GreatMesa/Servo-ESC/Hardware/SERVO-ESC/bob.stl

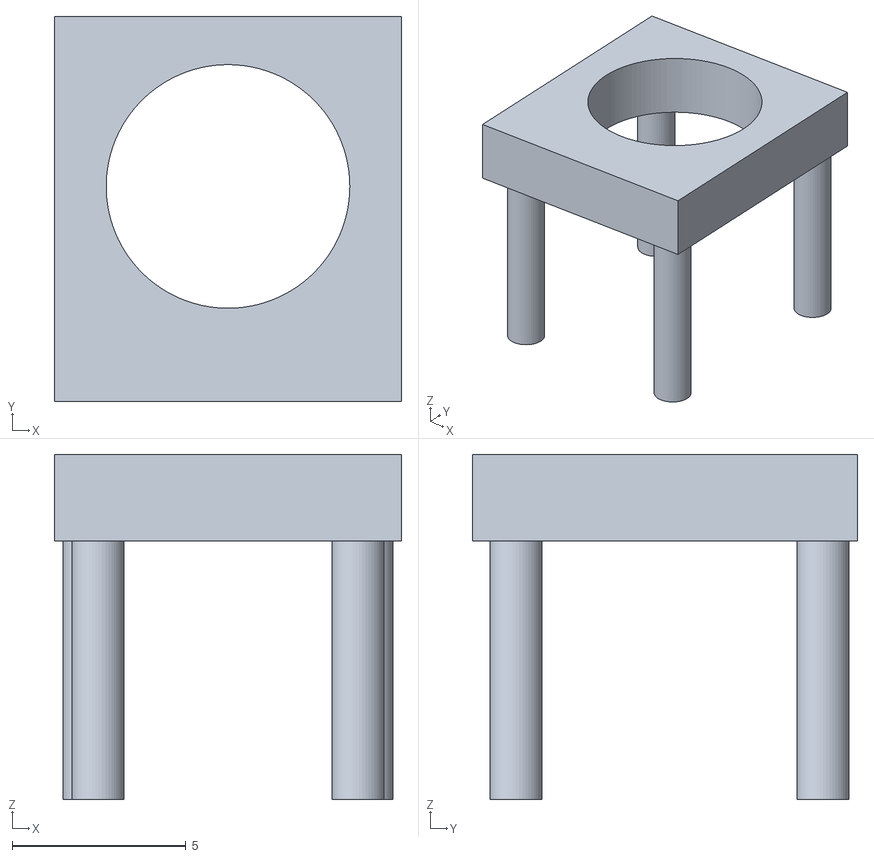
[picture p1: CAD file, 2026-04-23]
Hardware/SERVO-ESC/bob.stl
10.0 x 11.1 x 9.95
