GreatMesa/Servo-ESC/Hardware/SERVO-ESC/pan1.3mf

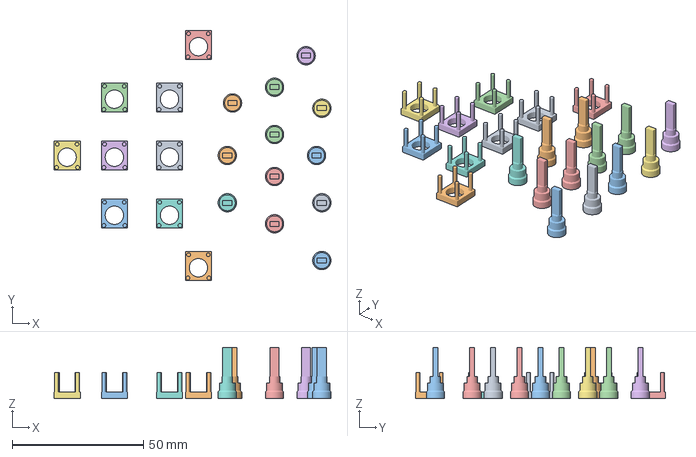
[picture p2: CAD file, 2026-04-23]
Hardware/SERVO-ESC/pan1.3mf
105.5 x 95.3 x 19.5 mm
bob.stl x 9
pan5.stl x 12
