GreatMesa/Servo-ESC/Hardware/SERVO-ESC/pan5.stl

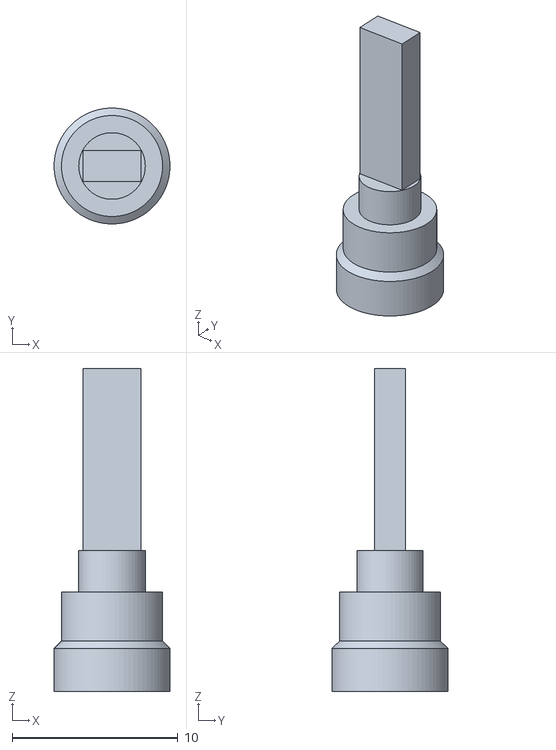
[picture p3: CAD file, 2026-04-23]
Hardware/SERVO-ESC/pan5.stl
7.00 x 7.00 x 19.5
