GreatMesa/Servo-ESC/Hardware/SERVO-ESC/pan.stl

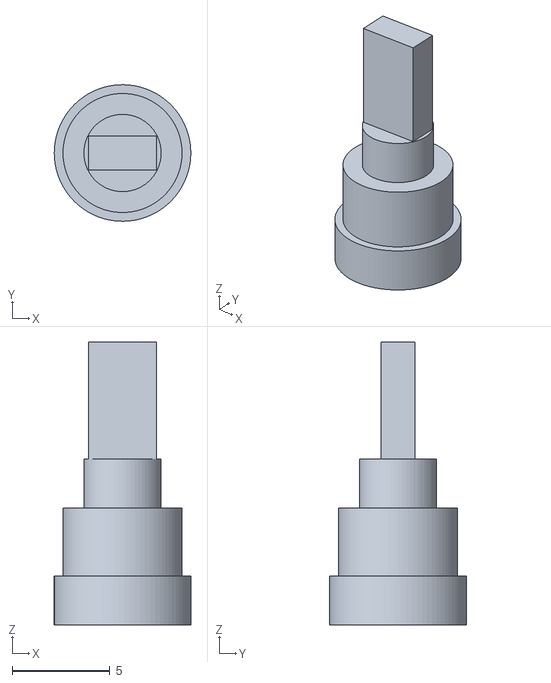
[picture p4: CAD file, 2026-03-27]
Hardware/SERVO-ESC/pan.stl
7.00 x 7.00 x 14.5
