GreatMesa/Servo-ESC/Hardware/SERVO-ESC/Untitled.stl

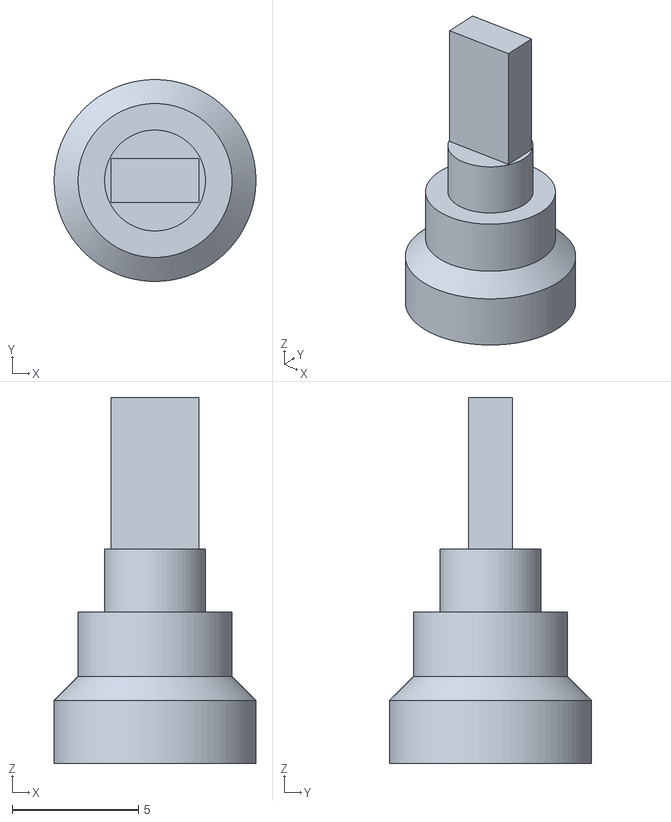
[picture p5: CAD file, 2026-03-27]
Hardware/SERVO-ESC/Untitled.stl
8.00 x 8.00 x 14.5
