GreatMesa/Servo-ESC/Hardware/SERVO-ESC/halp.stl

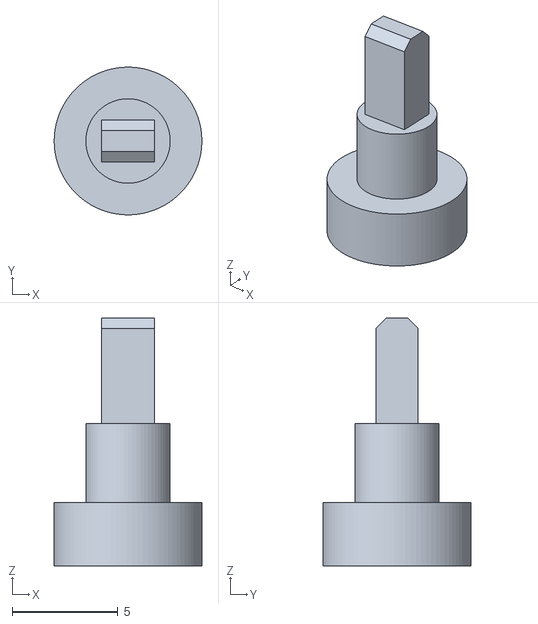
[picture p6: CAD file, 2026-03-24]
Hardware/SERVO-ESC/halp.stl
7.00 x 7.00 x 11.8
