GreatMesa/Servo-ESC/Hardware/SERVO-ESC/SERVO-ESC.step

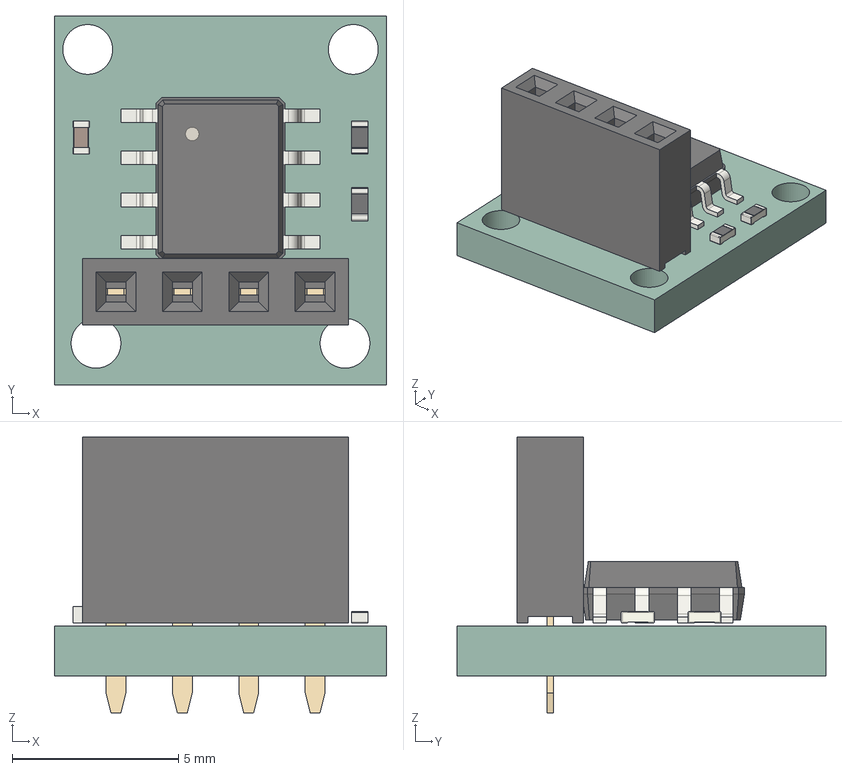
[picture p7: CAD file, 2026-03-24]
Hardware/SERVO-ESC/SERVO-ESC.step
10.0 x 11.1 x 8.30 mm
C_0402_1005Metric
R_0402_1005Metric x 2
PinSocket_1x04_P2.00mm_Vertical
SO-8_3.9x4.9mm_P1.27mm
SERVO-ESC_PCB
