GreatMesa/Servo-ESC/(list of files, cad)

Other CAD files:
Hardware/SERVO-ESC/pan2.stl
Hardware/SERVO-ESC/pan4.stl
Hardware/SERVO-ESC/pan3.stl
Hardware/SERVO-ESC/pan1.stl
