GreatMesa/Servo-ESC/Hardware/SERVO-ESC/SERVO-ESC.kicad_pcb

## KiCad design Hardware/SERVO-ESC/SERVO-ESC.kicad_pcb (2026-03-24)

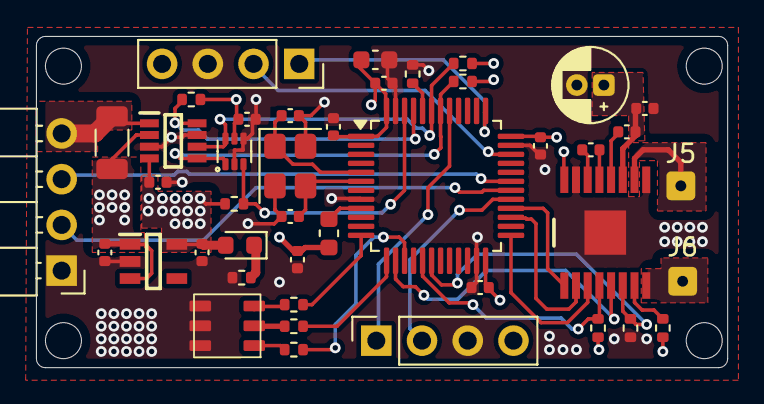
[picture p8: board SERVO-ESC.kicad_pcb from above]

Board: 4 copper layers, 38.4 x 18.4 mm, 43 parts (0 on the bottom side), 37 nets.

Parts:
C1, C2, C3, C4, C9, C10, C15: 100nF; C_0402_1005Metric
C5: 4.7uF; C_0603_1608Metric
C6, C8, C12: 1uF; C_0402_1005Metric
C7: 22nF; C_0402_1005Metric
C11: 22uF; CP_Radial_D4.0mm_P1.50mm
C13, C14: 30pF; C_0402_1005Metric
C16: 10nF; C_0402_1005Metric
D1: LED; LED_0603_1608Metric
FB1: FerriteBead; L_0603_1608Metric
IC1: AP2112K; SOT95P285X140-5N
IC2: DRV8876PWPR; SOP65P640X120-17N
IC4: TMP102xxDRL; SOT-563
IC5: INA236AIDDFR; SOP65P280X110-8N
J1: Conn_01x04_Pin; PinHeader_1x04_P2.54mm_Horizontal
J2, J4: Conn_01x04_Pin; PinSocket_1x04_P2.54mm_Vertical
J5: +; SolderWire-0.1sqmm_1x01_D0.4mm_OD1mm
J6: -; SolderWire-0.1sqmm_1x01_D0.4mm_OD1mm
LED1: Untitled_1
R1, R10: 10k; R_0402_1005Metric
R2, R3, R4: 220; R_0402_1005Metric
R5, R6, R12, R13: 4.7k; R_0402_1005Metric
R7: 1k; R_0402_1005Metric
R8: 62k; R_0402_1005Metric
R9: 8.25k; R_0402_1005Metric
R11: 0.01; R_1206_3216Metric
U1: STM32F301C8Tx; LQFP-48_7x7mm_P0.5mm
Y1: 25MHZ; Crystal_SMD_3225-4Pin_3.2x2.5mm

Connections:
+3.3V: C1.1, C2.1, C3.1, C4.1, C5.1, C8.1, C12.1, C15.1, C16.1, D1.2 (A), FB1.2, IC1.5 (VOUT), IC2.16 (PMODE), IC4.5 (V+), IC5.4 (VS), J2.4, J4.4, R5.1, R6.1, R8.2, R10.1, R12.1, R13.1, U1.1 (VBAT), U1.24 (VDD), U1.36 (VDD), U1.48 (VDD)
+3.3VA: FB1.1, U1.9 (VDDA)
+7V: C6.1, C9.1, C10.1, C11.1, IC1.1 (VIN), IC1.3 (EN), IC2.11 (VM), IC5.2 (IN-), R11.2
+SV: IC5.1 (IN+), J1.4, R11.1
CPH: C7.2, IC2.13 (CPH)
CPL: C7.1, IC2.14 (CPL)
GND: C1.2, C2.2, C3.2, C4.2, C5.2, C6.2, C8.2, C9.2, C11.2, C12.2, C13.2, C14.2, C15.2, C16.2, IC1.2 (GND), IC2.9 (PGND), IC2.15 (GND), IC2.17 (EP), IC4.2 (GND), IC4.4 (ADD0), IC5.3 (GND), IC5.7 (A0), J1.1, J2.3, J4.3, LED1.1, LED1.2, LED1.3, R1.1, R7.2, R9.2, U1.8 (VSSA), U1.23 (VSS), U1.35 (VSS), U1.47 (VSS), Y1.2, Y1.4
HBRIDGE+: IC2.8 (OUT1), J6.1
HBRIDGE-: IC2.10 (OUT2), J5.1
HBRIDGE-FAULT: IC2.4 (NFAULT), R8.1, U1.17 (PA7)
HBRIDGE-IMODE: IC2.7 (IMODE), R10.2
HBRIDGE-IN1: IC2.1 (EN/IN1), U1.28 (PB15)
HBRIDGE-IN2: IC2.2 (PH/IN2), U1.27 (PB14)
HBRIDGE-IPROPI: IC2.6 (IPROPI), R9.1, U1.18 (PB0)
HBRIDGE-SLEEP: IC2.3 (NSLEEP), U1.25 (PB12)
HBRIDGE-VREF: IC2.5 (VREF), U1.14 (PA4)
HSE-IN: C13.1, U1.5 (PF0), Y1.1
HSE-OUT: C14.1, U1.6 (PF1), Y1.3
I2C-SCL-1: IC4.1 (SCL), IC5.5 (SCL), R5.2, U1.42 (PB6)
I2C-SCL-3: J4.2, U1.29 (PA8)
I2C-SDA-1: IC4.6 (SDA), IC5.6 (SDA), R6.2, U1.43 (PB7)
I2C-SDA-3: J4.1, U1.41 (PB5)
INA236-INT: IC5.8 (~ALERT), R12.2, U1.45 (PB8)
unnamed: D1.1 (K), R7.1
unnamed: LED1.4, R2.1
unnamed: LED1.5, R3.1
unnamed: LED1.6, R4.1
unnamed: R1.2, U1.44 (BOOT0)
RGB-LED-BLUE: R4.2, U1.12 (PA2)
RGB-LED-GREEN: R3.2, U1.13 (PA3)
RGB-LED-RED: R2.2, U1.15 (PA5)
SWCLK: J2.1, U1.37 (PA14)
SWDIO: J2.2, U1.34 (PA13)
TMP102-INT: IC4.3 (ALERT), R13.2, U1.46 (PB9)
UART-RX: J1.3, U1.31 (PA10)
UART-TX: J1.2, U1.30 (PA9)
VCP: C10.2, IC2.12 (VCP)
