GreatMesa/Servo-ESC/Software/Core/Src/main.c

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
/* Includes ------------------------------------------------------------------*/
#include "main.h"
#include "cmsis_os.h"
#include "stdbool.h"
#include "DRV8876.h"
#include "RGBLED.h"
#include "INA236.h"
#include "MT6701.h"
#include "TMP102.h"
#include "pid.h"
#include "cmsis_os2.h"
#include "stm32f3xx_hal_gpio.h"
#include <stdint.h>
#include <sys/types.h>
#define ina236Flag (1U << 0)
#define tmp102Flag (1U << 1)
ADC_HandleTypeDef hadc1;

DAC_HandleTypeDef hdac;

I2C_HandleTypeDef hi2c1;
I2C_HandleTypeDef hi2c2;
I2C_HandleTypeDef hi2c3;

TIM_HandleTypeDef htim2;
TIM_HandleTypeDef htim15;

void diagnosticsTask(void *argument);
void encoderTask(void *argument);
void driverTask(void *argument);
void pidTask(void *argument);
void i2cslaveTask(void *argument);

/*Diagnostics Task Handle*/
osThreadId_t diagnosticsTaskHandle;
const osThreadAttr_t diagnosticsTask_attr = {
  .name = "Diagnositic Task",
  .stack_size = 128 * 4,
  .priority = (osPriority_t) osPriorityLow,
};
/*MT6701 Encoder Task Handle*/
osThreadId_t encoderTaskHandle;
const osThreadAttr_t encoderTask_attr = {
  .name = "Encoder Task",
  .stack_size = 128 * 4,
  .priority = (osPriority_t) osPriorityNormal,
};
/*DRV8876 Task*/
osThreadId_t driverTaskHandle;
const osThreadAttr_t driverTask_attr = {
  .name = "Driver Task",
  .stack_size = 128 * 4,
  .priority = (osPriority_t) osPriorityNormal,
};

osThreadId_t pidTaskHandle;
const osThreadAttr_t pidTask_attr = {
  .name = "PID Task",
  .stack_size = 128 * 4,
  .priority = (osPriority_t) osPriorityNormal,
};

osThreadId_t i2cslaveTaskHandle;
const osThreadAttr_t i2cslaveTask_attr = {
  .name = "I2C Task",
  .stack_size = 128 * 4,
  .priority = (osPriority_t) osPriorityNormal,
};

/* USER CODE BEGIN PV */
DRV8876 drv;
MT6701 encoder;
RGBLED led;
INA236 ina;
TMP102 tmp;
PID pid;
/* USER CODE END PV */

void SystemClock_Config(void);
static void MX_GPIO_Init(void);
static void MX_ADC1_Init(void);
static void MX_DAC_Init(void);
static void MX_I2C1_Init(void);
static void MX_TIM2_Init(void);
static void MX_I2C3_Init(void);
static void MX_TIM15_Init(void);
static void MX_I2C2_Init(void);

/**
  * @brief  The application entry point.
  * @retval int
  */
int main(void)
{
  /* MCU Configuration--------------------------------------------------------*/

  /* Reset of all peripherals, Initializes the Flash interface and the Systick. */
  HAL_Init();
  /* Configure the system clock */
  SystemClock_Config();

  /* Initialize all configured peripherals */
  MX_GPIO_Init();

  MX_ADC1_Init();
  MX_DAC_Init();
  MX_I2C1_Init();
  MX_TIM2_Init();
  MX_I2C3_Init();
  MX_TIM15_Init();
  MX_I2C2_Init();
  /* USER CODE BEGIN 2 */
  /* Initializing Drivers */
  INA236_Initialize(&ina, &hi2c1);
  TMP102_Initialize(&tmp, &hi2c1, TMP102_ALERT_GPIO_Port);
  MT6701_Initialize(&encoder, &hi2c3);
  DRV8876_Initialize(&drv, &htim15, &hadc1, &hdac, HBRIDGE_SLEEP_GPIO_Port,HBRIDGE_SLEEP_Pin, HBRIDGE_FALUT_GPIO_Port, HBRIDGE_FALUT_Pin);
  RGBLED_Initialize(&led, &htim2);
  PID_Initialize(&pid, 0.1 , 0.2, 0.3, 0.4, 0.5);
  setVelocity(&drv, 64000);
  /* USER CODE END 2 */
  
  /* Init scheduler */
  osKernelInitialize();

  /* USER CODE BEGIN RTOS_MUTEX */
  /* add mutexes, ... */
  /* USER CODE END RTOS_MUTEX */

  /* USER CODE BEGIN RTOS_SEMAPHORES */
  /* add semaphores, ... */
  /* USER CODE END RTOS_SEMAPHORES */

  /* USER CODE BEGIN RTOS_TIMERS */
  /* start timers, add new ones, ... */
  /* USER CODE END RTOS_TIMERS */

  /* USER CODE BEGIN RTOS_QUEUES */
  /* add queues, ... */
  /* USER CODE END RTOS_QUEUES */

  /* Create the thread(s) */
  /* creation of defaultTask */

  /* USER CODE BEGIN RTOS_THREADS */
  diagnosticsTaskHandle = osThreadNew(diagnosticsTask,NULL,&diagnosticsTask_attr);
  encoderTaskHandle = osThreadNew(encoderTask,NULL,&encoderTask_attr);
  driverTaskHandle = osThreadNew(driverTask,NULL,&driverTask_attr);
  //pidTaskHandle = osThreadNew(pidTask,NULL,&pidTask_attr);
  //i2cslaveTaskHandle = osThreadNew(i2cslaveTask,NULL,&i2cslaveTask_attr);
  /* add threads, ... */
  /* USER CODE END RTOS_THREADS */

  /* USER CODE BEGIN RTOS_EVENTS */
  /* add events, ... */
  /* USER CODE END RTOS_EVENTS */
  
  /* Start scheduler */
  osKernelStart();

  /* We should never get here as control is now taken by the scheduler */

  /* Infinite loop */
  /* USER CODE BEGIN WHILE */
  while (1)
  {
    /* USER CODE END WHILE */

    /* USER CODE BEGIN 3 */
  }
  /* USER CODE END 3 */
}


void diagnosticsTask(void *argument)
{
  for(;;)
  {
    uint32_t flags = osThreadFlagsWait(tmp102Flag | ina236Flag, osFlagsWaitAny, osWaitForever);
      if(flags & tmp102Flag)
      {
        TMP102_Read(&tmp);
      }
      if(flags & ina236Flag)
      {
        INA236_Read(&ina);
      }
  }
}

void encoderTask(void *argument)
{
  for(;;)
  {
    MT6701_Read(&encoder);
    getRPM(&encoder, 10,0.2);
    osDelay(5);
  }
}
void pidTask(void *argument)
{
  for(;;)
  {
    PID_Step(&pid, 7, 8, 5, 5, 4, 4);
    setVelocity(&drv, pid.power);
  }
}

void driverTask(void *argument)
{
    for(;;)
  {
    if(drv.state == SLEEP)
    {
        HAL_GPIO_WritePin(HBRIDGE_SLEEP_GPIO_Port, HBRIDGE_SLEEP_Pin, 0);
    }
    else if(drv.state == COAST)
    {
        //Slows down the motor with a gradual decent.
        HAL_GPIO_WritePin(HBRIDGE_SLEEP_GPIO_Port, HBRIDGE_SLEEP_Pin, 1);
        __HAL_TIM_SET_COMPARE(drv.tim, TIM_CHANNEL_1, 0);
        __HAL_TIM_SET_COMPARE(drv.tim, TIM_CHANNEL_2, 0);
    }
    else if(drv.state == REVERSE)
    {
        /*
        */
        HAL_GPIO_WritePin(HBRIDGE_SLEEP_GPIO_Port, HBRIDGE_SLEEP_Pin, 1);
        __HAL_TIM_SET_COMPARE(drv.tim, TIM_CHANNEL_1, 0);
        __HAL_TIM_SET_COMPARE(drv.tim, TIM_CHANNEL_2, drv.speed);
    }
    else if(drv.state == FORWARD)
    {
        HAL_GPIO_WritePin(HBRIDGE_SLEEP_GPIO_Port, HBRIDGE_SLEEP_Pin, 1);
        __HAL_TIM_SET_COMPARE(drv.tim, TIM_CHANNEL_1, drv.speed);
        __HAL_TIM_SET_COMPARE(drv.tim, TIM_CHANNEL_2, 0);
    }
    else if(drv.state == BRAKE)
    {
        HAL_GPIO_WritePin(HBRIDGE_SLEEP_GPIO_Port, HBRIDGE_SLEEP_Pin, 1);
        __HAL_TIM_SET_COMPARE(drv.tim, TIM_CHANNEL_1, 65535);
        __HAL_TIM_SET_COMPARE(drv.tim, TIM_CHANNEL_2, 0);
    }
    setColor(&led, drv.state);
  }
}
void i2cslaveTask(void *argument)
{
  
}
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
