GreatMesa/Servo-ESC/Software/SERVO-ESC.ioc

Mcu.UserName=STM32F301C8Tx
PA10.Signal=I2C2_SDA
PA13.Signal=SYS_JTMS-SWDIO
PA14.Signal=SYS_JTCK-SWCLK
PA2.GPIO_Label=RGB_LED_BLUE
PA2.Signal=S_TIM2_CH3
PA3.GPIO_Label=RGB_LED_GREEN
PA3.Signal=S_TIM2_CH4
PA4.GPIO_Label=HBRIDGE-VREF
PA4.Signal=COMP_DAC1_group
PA5.GPIO_Label=RGB_LED_RED
PA5.Signal=S_TIM2_CH1_ETR
PA7.GPIO_Label=HBRIDGE-FALUT
PA7.Signal=GPIO_Input
PA8.Signal=I2C3_SCL
PA9.Signal=I2C2_SCL
PB0.GPIO_Label=HBRIDGE-IPROPI
PB0.Signal=ADC1_IN11
PB12.GPIO_Label=HBRIDGE-SLEEP
PB12.Signal=GPIO_Output
PB14.Signal=S_TIM15_CH1
PB15.Signal=S_TIM15_CH2
PB5.Signal=I2C3_SDA
PB6.Signal=I2C1_SCL
PB7.Signal=I2C1_SDA
PB8.GPIO_Label=INA236_ALERT
PB8.Signal=GPXTI8
PB9.GPIO_Label=TMP102_ALERT
PB9.Signal=GPXTI9
PF0-OSC_IN.Signal=RCC_OSC_IN
PF1-OSC_OUT.Signal=RCC_OSC_OUT
