GreatMesa/Servo-ESC/Software/Core/Src/INA236.c

#include "INA236.h"
#include "stm32f3xx_hal_i2c.h"
#include <stdint.h>

uint16_t INA236_Config()
{
    // Converts initial configuration values into 16-bit message.
    return ((INA236_CONFIG_RST << 15) |
            (INA236_CONFIG_ADC_RANGE << 12) | 
            (INA236_CONFIG_AVG << 9) |
            (INA236_CONFIG_VBUSCT << 6) |
            (INA236_CONFIG_VSHCT << 3) |
            INA236_CONFIG_MODE);
}

uint16_t INA236_Callibration()
{
    // Converts shunt resistor value into needed shunt constant.
    float current_lsb = (INA236_MAX_CURRENT / 32768.0f);
    uint16_t SHUNT_CAL = ((0.00512f) / ((INA236_SHUNT_RESISTANCE) * (current_lsb))) / 4;
    return SHUNT_CAL;
}


HAL_StatusTypeDef INA236_Initialize(INA236 *ina236, I2C_HandleTypeDef *I2Chandle)
{
    // Configuring Starting Values
    ina236->I2Chandle = I2Chandle;
    ina236->config = INA236_Config();
    ina236->callibration = INA236_Callibration();
    ina236->raw_current = 0;
    ina236->raw_voltage = 0;
    ina236->raw_power = 0;
    ina236->current = 0.0f;
    ina236->power = 0.0f;
    ina236->voltage = 0.0f;
    ina236->current_lsb = (INA236_MAX_CURRENT / 32768.0f);
    uint8_t txBuf[2];
    
    //Configuring Configuration Register
    txBuf[0] = ((ina236->config >> 8) & 0xFF); txBuf[1] = (ina236->config & 0xFF);
    ina236->hal = HAL_I2C_Mem_Write(ina236->I2Chandle, INA236_I2C_ADDRESS,INA_CONFIG_REGISTER,I2C_MEMADD_SIZE_8BIT, txBuf, 2, 100);
    if(ina236->hal != HAL_OK){return ina236->hal;}
    
    //Configuring Callibration Register
    txBuf[0] = ((ina236->callibration >> 8) & 0xFF); txBuf[1] = (ina236->callibration & 0xFF);
    ina236->hal = HAL_I2C_Mem_Write(ina236->I2Chandle, INA236_I2C_ADDRESS,CALLIBRATION_REGISTER,I2C_MEMADD_SIZE_8BIT, txBuf, 2, 100);
    if(ina236->hal != HAL_OK){return ina236->hal;}
    
    //Configuring Mask \ Enable Register
    txBuf[0] = (0b00000100); txBuf[1] = (0b00000000);
    ina236->hal = HAL_I2C_Mem_Write(ina236->I2Chandle, INA236_I2C_ADDRESS,MASK_ENABLE_REGISTER,I2C_MEMADD_SIZE_8BIT, txBuf, 2, 100);
    if(ina236->hal != HAL_OK){return ina236->hal;}
    return ina236->hal;
}

void getCurrent(INA236 *ina236)
{
    // Requests the 16-bit raw current value.
    uint8_t rxBuf[2];
    HAL_I2C_Mem_Read(ina236->I2Chandle, INA236_I2C_ADDRESS, CURRENT_REGISTER, I2C_MEMADD_SIZE_8BIT, rxBuf, 2, 100);
    int16_t raw_current = ((rxBuf[0] << 8) | (rxBuf[1]));
    ina236->raw_current = raw_current;
    // Calculates the actual current value.
    ina236->current = raw_current * ina236->current_lsb;
}

void getVoltage(INA236 *ina236)
{
    // Requests the 16-bit raw voltage value.
    uint8_t rxBuf[2];
    HAL_I2C_Mem_Read(ina236->I2Chandle, INA236_I2C_ADDRESS, VOLTAGE_REGISTER, I2C_MEMADD_SIZE_8BIT, rxBuf, 2, 100);
    int16_t raw_voltage = ((rxBuf[0] << 8) | (rxBuf[1]));
    ina236->raw_voltage = raw_voltage;
    // Calculates the actual voltage value.
    ina236->voltage = raw_voltage * 0.0016f;
}

void getPower(INA236 *ina236)
{
    // Requests the 16-bit raw power value.
    uint8_t rxBuf[2];
    HAL_I2C_Mem_Read(ina236->I2Chandle, INA236_I2C_ADDRESS, POWER_REGISTER, I2C_MEMADD_SIZE_8BIT, rxBuf, 2, 100);
    int16_t raw_power = ((rxBuf[0] << 8) | (rxBuf[1]));
    float current_lsb = (INA236_MAX_CURRENT / 32768.0f);
    ina236->raw_power = raw_power;
    // Calculates the actual voltage value.
    ina236->power = raw_power * current_lsb * 32;
}

void INA236_Read(INA236 *ina236)
{
    getCurrent(ina236);
    getVoltage(ina236);
    getPower(ina236);
    INA236_Release(ina236);
}

void INA236_Release(INA236 * ina236)
{
    uint8_t rxBuf[2];
    HAL_I2C_Mem_Read(ina236->I2Chandle, INA236_I2C_ADDRESS,
                 MASK_ENABLE_REGISTER, I2C_MEMADD_SIZE_8BIT,
                 rxBuf, 2, 100);
}
