GreatMesa/Servo-ESC/(commit log)

2025-11-02 Added PCB Files
    [SERVO-ESC-B_Cu.gbr, SERVO-ESC-B_Mask.gbr, SERVO-ESC-B_Paste.gbr, SERVO-ESC-B_Silkscreen.gbr, SERVO-ESC-Edge_Cuts.gbr, SERVO-ESC-F_Cu.gbr, SERVO-ESC-F_Mask.gbr, SERVO-ESC-F_Paste.gbr]
2026-01-02 New PCB Files
    [SERVO-ESC-B_Cu.gbr, SERVO-ESC-B_Mask.gbr, SERVO-ESC-B_Paste.gbr, SERVO-ESC-B_Silkscreen.gbr, SERVO-ESC-Edge_Cuts.gbr, SERVO-ESC-F_Cu.gbr, SERVO-ESC-F_Mask.gbr, SERVO-ESC-F_Paste.gbr]
2026-03-17 New Commit
    [SERVO-ESC-B_Cu.gbr, SERVO-ESC-B_Mask.gbr, SERVO-ESC-B_Paste.gbr, SERVO-ESC-B_Silkscreen.gbr, SERVO-ESC-Edge_Cuts.gbr, SERVO-ESC-F_Cu.gbr, SERVO-ESC-F_Mask.gbr, SERVO-ESC-F_Paste.gbr]
2026-03-18 New stuff
    [SERVO-ESC.kicad_sch]
2026-03-18 Ediited MT6701 Driver
2026-03-24 New board files (messed up gnd via)
    [SERVO-ESC-B_Cu.gbr, SERVO-ESC-B_Mask.gbr, SERVO-ESC-B_Paste.gbr, SERVO-ESC-B_Silkscreen.gbr, SERVO-ESC-Edge_Cuts.gbr, SERVO-ESC-F_Cu.gbr, SERVO-ESC-F_Mask.gbr, SERVO-ESC-F_Paste.gbr]
2026-03-27 Adding new task structures
    [Untitled.stl, pan.stl, pan1.stl, pan2.stl, pan3.stl, pan4.stl, pan5.stl]
2026-04-23 New software + motor moving.
    [SERVO-ESC.kicad_sch, bob.stl, pan1.3mf, pan5.stl]
